speck0413/specter-proptroller/enclosure/docs/lid-hinges-latches.png

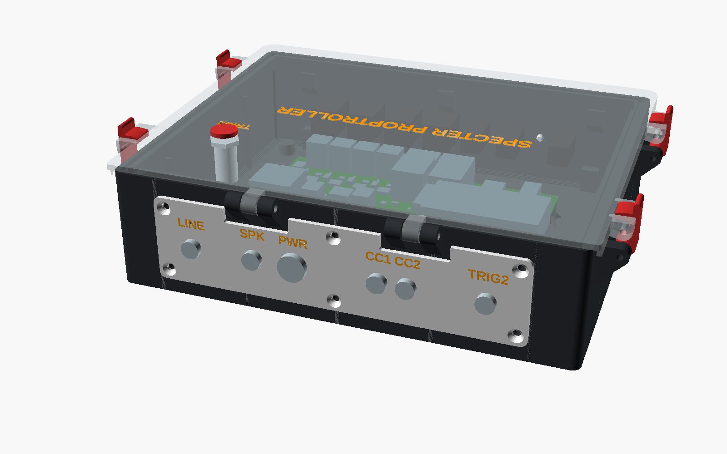
enclosure/docs/lid-hinges-latches.png
