speck0413/specter-proptroller/enclosure/docs/tub-underside.png

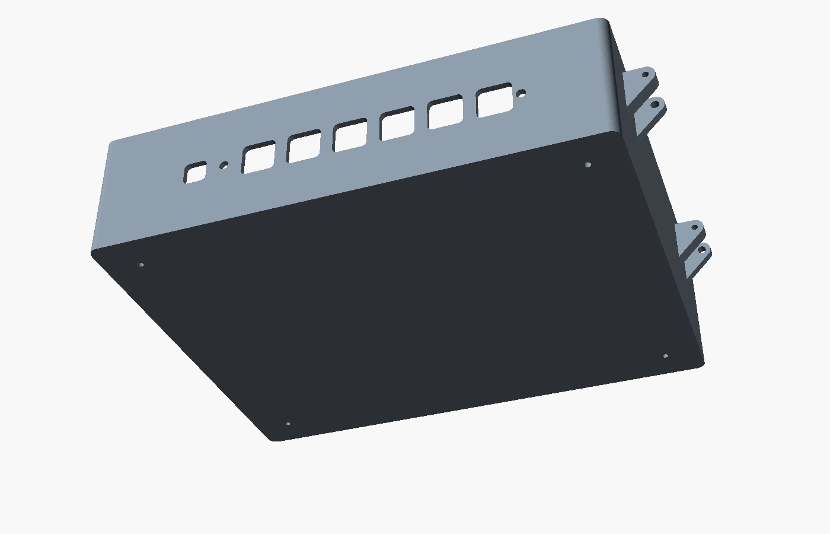
enclosure/docs/tub-underside.png
