speck0413/specter-proptroller/enclosure/docs/tub.png

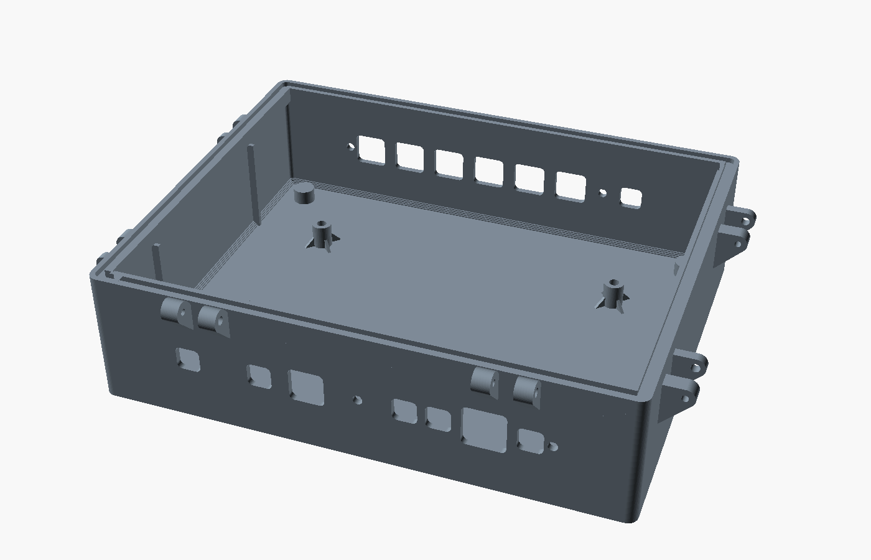
enclosure/docs/tub.png
