speck0413/specter-proptroller/hardware/fab/order/1-jlc-fits-everything/bom.csv

Comment | Designator | Footprint | LCSC Part #
DC-005-5A-2.0 24V | J_PWR | BarrelJack_Horizontal | C381116
100u/50V 50V Al-elec | C_BK1,C_BK2,C_DF | CP_Elec_8x10 | C970687
100n 50V X7R | C_BST,C_DFH,C_MCU,C_T1,C_T2 | C_0805_2012Metric | C49678
10u 16V X5R | C_LL,C_LR | C_0805_2012Metric | C1713
47p/50V 50V C0G | C_CF | C_0805_2012Metric | C14857
6.8n/50V 50V X7R | C_CP | C_0805_2012Metric | C1755
10u/50V 50V X5R | C_BI1,C_BI2 | C_1206_3216Metric | C13585
47u/10V 10V X5R | C_BO1,C_BO2 | C_1206_3216Metric | C96123
SMAJ24A | D_TVS | D_SMA | C19077541
SS56 60V | D_CT1,D_CT2,D_F1,D_F2,D_F3,D_F4 | D_SMA | C18199169
1N4148W | D_TC1,D_TC2 | D_SOD-123 | C81598
B5819W | D_C1,D_C2,D_DF,D_MCU | D_SOD-123 | C8598
PJ-320D | J_C1,J_C2,J_LO,J_T1,J_T2 | Jack_3.5mm_PJ320D_Horizontal | C431535
green | D_LO1,D_LO2,D_LO3,D_LO4,D_RL1,D_RL2 | LED_0805_2012Metric | C2297
220R@100M 3A | FB_BK,FB_DF | L_0805_2012Metric | C76818
10uH 8.8A | L_BK | L_Sunlord_MWSA1005S | C17700185
10k 1% | R_LO1,R_LO2,R_LO3,R_LO4 | R_0805_2012Metric | C17414
13k 1% | R_CP | R_0805_2012Metric | C17455
150k 1% | R_RT | R_0805_2012Metric | C17470
1k 1% | R_DFT,R_LL,R_LR,R_RB1,R_RB2,R_RL1,R_RL2,R_X1,R_X2,R_X3,R_X4,R_X5,R_X6,R_X7,R_X8,R_X9,R_X10,R_X11 | R_0805_2012Metric | C17513
220 1% | R_CA1,R_CA2,R_TR1,R_TR2 | R_0805_2012Metric | C17557
330 1% | R_PXS | R_0805_2012Metric | C17630
4.7k 1% | R_CP1,R_CP2,R_GD1,R_GD2,R_GD3,R_GD4,R_GS1,R_GS2,R_GS3,R_GS4,R_PD1,R_PD2,R_PD3,R_PD4,R_PXG,R_RP1,R_RP2,R_TS1,R_TS2,R_TU1,R_TU2 | R_0805_2012Metric | C17673
43k 1% | R_FB1 | R_0805_2012Metric | C17695
470 1% | R_PXU | R_0805_2012Metric | C17710
8.2k 1% | R_FB2 | R_0805_2012Metric | C17828
SRD-05VDC-SL-C | K1,K2 | Relay_SPDT_SANYOU_SRD_Series_Form_C | C35449
AO4485 | Q_O1,Q_O2,Q_O3,Q_O4 | SOIC-8_3.9x4.9mm_P1.27mm | C51499
LTV-217-B-G | U_C1,U_C2 | SOP-4_4.4x2.6mm_P1.27mm | C115450
2N7002 | Q_D1,Q_D2,Q_D3,Q_D4,Q_PX | SOT-23 | C8545
MMBT3904 | Q_R1,Q_R2 | SOT-23 | C20526
TS-1187A | SW_U1,SW_U2,SW_U3 | SW_Push_1P1T_XKB_TS-1187A | C318884
TPS54360BDDAR | U_BK | TI_SO-PowerPAD-8 | C524806
WJ500V-5.08-2P screw terminal | J_IN,J_O1,J_O2,J_O3,J_O4,J_SPK | TerminalBlock_5.08mm_1x02 | C8465
WJ500V-5.08-3P screw terminal | J_R1,J_R2,J_PX | TerminalBlock_5.08mm_1x03 | C72334
WJ500V-5.08-5P screw terminal | J_RAIL | TerminalBlock_5.08mm_1x05 | C42377750
2541FV-15P-B 1x15 female 8.5mm | J_DKN,J_DKS | PinSocket_1x15_P2.54mm_Vertical | C25503121
PM2.54-1X8PM-H85 1x8 female 8.5mm | J_DFA,J_DFB | PinSocket_1x08_P2.54mm_Vertical | C42431840
PZ254V-11-11P 1x11 male | J_XS,J_XV,J_XG | PinHeader_1x11_P2.54mm_Vertical | C2840011
2541FV-20P-B 1x20 female 8.5mm | J_PIN,J_PIS | PinSocket_1x20_P2.54mm_Vertical | C25503124
