speck0413/specter-proptroller/enclosure/params.scad

// generated by tools/print_params.py from design.toml and the board; edit design.toml, not this file

wall = 2.4;
floor_t = 2.0;
corner_r = 4.0;
row_v = 12.0;
standoff_h = 10.0;
inner_h = 51.0;
ribs = [-40.0, 40.0];
feet_in = 12.0;
feet_boss_d = 9.0;
feet_boss_h = 6.0;
feet_pilot = 2.5;
feet_depth = 7.0;
mount = "inset";
inset_d = 1.0;
inset_clr = 0.3;
inset_key = 6.0;
break_pitch = 20.0;
break_t = 0.8;
break_neck = 1.0;
plate_t = 3.0;
plate_r = 3.0;
plate_chamfer = 1.0;
pin_d = 3.3;
pin_l = 4.0;
pin_wall = 1.2;
ring_m = 1.0;
ring_edge = 3.5;
pg_w = 2.0;
pg_d = 1.0;
sg_w = 3.5;
sg_d = 1.6;
sg_m = 2.0;
sg_land = 3.6;
sg_edge = 1.75;
sg_round = 1.2;
screw_layout = "six";
screw_pitch = 36.0;
boss_w = 10.0;
boss_h = 8.5;
boss_len = 4.75;
j35_seat = 1.75;
label_h = 4.0;
label_base = 9.1;
label_gap = 1.0;
label_rows = 2;
inlay = 0.4;
gasket_clr = 0.1;
gasket_base = 0.4;
gasket_h = 2.8;
gasket_lip = 0.45;
gasket_tip = 0.85;
gasket_tip_lid = 1.2;
land_w = 7.0;
land_h = 6.0;
groove_w = 3.0;
groove_d = 2.0;
tongue_w = 1.6;
tongue_h = 0.7;
foam_t = 3.2;
seal_gap = 0.4;
lid_mount = "screws";
lid_screw_d = 4.5;
lid_screw_r = 3.75;
lid_screw_gap = 0.2;
lid_screw_pilot = 2.5;
lid_screw_depth = 6.0;
lid_ear_h = 6.0;
lid_screw_front = 14.0;
lid_screw_back = 4.5;
lid_t = 2.4;
lid_gap = 1.0;
skirt_t = 2.0;
drip = 4.0;
lid_rib_h = 5.0;
lid_rib_pitch = 40.0;
knuckle_d = 8.0;
knuckle_off = 1.25;
pin_span = 20.4;
knuckle_gap = 0.6;
latch_w = 10.0;
latch_drop = 12.0;
latch_bite = 0.4;
latch_in = 30.0;
latch_lead = 0.5;
latch_detent = 0.4;
latch_dip = 6.0;
latch_travel = 16.0;
latch_style = "cam";
dl_drop = 16.0;
dl_out = 9.5;
dl_r = 7.5;
dl_over = 15.0;
dl_squeeze = 0.5;
dl_reach = 2.6;
dl_tip_t = 2.8;
dl_pin = 4.0;
dl_lever_t = 8.0;
dl_ear_t = 4.0;
dl_plate_t = 3.5;
dl_gap = 0.4;
dl_ear_r = 4.0;
dl_boss_r = 4.2;
ear_t = 3.6;
title = "SPECTER PROPTROLLER";
ac = false;
ac_barrier_t = 2.0;
ac_bay_cap = 2.0;
ac_barrier_gap = 1.0;
ac_pocket_d = 34.0;
ac_pocket_m = 4.0;
ac_window_top = 2.0;
ac_sill_gap = 1.0;
ac_overlap = 3.0;
ac_rib_gap = 0.5;
ac_tie = [8.0, 8.0, 14.0, 5.0, 2.0];
ac_face_set = 0.25;
ac_earth_point = [4.0, 76.0];
ac_earth_hole = 3.2;
ac_earth_west = 17.5;
ac_earth_bend = 6.0;
ac_earth_niche = 6.0;
ac_earth2_point = [130.0, 4.0];
ac_earth2_back = 8.0;
win_m = 0.6;
pin_clr = 0.15;
hole_usb = 12.4;
hole_button = 10.4;
hole_j35p = 8.0;
hole_dcp = 12.0;
screw_head = 6.3;
screw_head_angle = 90.0;
screw_pan = false;
screw_d = 3.4;
insert_d = 4.0;
insert_depth = 6.5;
nut_af = 5.5;
nut_t = 2.4;
nut_clr = 0.2;
standoff_hole = 4.0;
standoff_depth = 7.0;
pin_pilot = 2.5;
plate_pilot = 2.5;
gasket_swing = 0.88;
gasket_lid_squeeze = 1.1;
gasket_lid_swing = 1.17;
knuckle_l = 6.4;
board_t = 1.6;
ix0 = -31.0;
ix1 = 164.0;
iyf = -118.0;
iyb = 38.0;
hinge_xs = [33.19, 99.81];
z_floor = 2.0;
z_board = 12.0;
z_row = 25.6;
z_top = 53.0;
latches = [["left", -88.0], ["left", 8.0], ["right", -88.0], ["right", 8.0]];
dl_p1 = [9.5, 37.0];
dl_p2 = [10.555, 29.575];
dl_k = [1.7, 55.3];
dl_lh = 27.207;
dl_snap = 0.186;
dl_open = 60;
button_xy = [129.0, 10.0];
lid_ears = [["left", -40.0], ["right", -40.0], ["front", -15.4], ["front", 148.4], ["back", -24.9], ["back", 157.9]];
ac_barrier = [];
ac_curtain = [];
ac_gland = [];
ac_earth = [];
ac_ties = [];
ac_cover = [];
ac_cover_bosses = [];
ac_chimney = [];
ac_seat = 0.0;
ac_seat_inset = 0.0;
ac_cover_z = 0.0;
ac_ribs = [];
ac_shelf = [];
ac_lip = [];
ac_stops = [];
ac_niche_out = [];
ac_earth2 = [];
feet_cap = 1.0;
board_w = 134; board_h = 80;
board_holes = [[4, -4], [130, -4], [4, -76], [130, -76]];
board_parts = [[57.5, -43.55, 1.6, 60.0, -40.55, 2.79], [115.85, -45.03, 1.6, 117.85, -43.78, 2.84], [109.82, -65.81, 1.6, 111.07, -63.81, 2.7], [60.73, -21.85, 1.6, 88.67, -19.31, 10.13], [18.05, -63.95, 1.6, 23.05, -61.25, 3.82], [88.75, -57.35, 1.6, 94.75, -52.44, 3.34], [101.75, -62.94, 1.6, 104.75, -60.44, 2.79], [15.97, -59.36, 1.6, 17.22, -57.36, 2.84], [26.1, -51.88, 1.6, 28.1, -50.62, 2.84], [25.0, -76.0, 1.6, 35.0, -64.5, 6.39], [28.5, -76.0, 1.6, 31.5, -64.5, 3.04], [49.4, -28.55, 1.6, 56.4, -25.95, 3.7], [27.45, -31.9, 1.6, 29.05, -28.1, 2.85], [40.4, -68.8, 1.6, 55.8, -49.2, 17.19], [102.95, -14.69, 1.6, 112.25, -0.49, 12.29], [74.25, -44.75, 1.6, 76.75, -41.75, 2.79], [96.5, -61.84, 1.6, 99.2, -56.84, 3.82], [37.8, -28.55, 1.6, 44.8, -25.95, 3.7], [34.2, -61.2, 1.6, 35.8, -58.0, 3.2], [20.7, -74.4, 1.6, 23.9, -72.8, 3.2], [77.05, -62.94, 1.6, 80.05, -60.44, 2.79], [11.45, -16.45, 1.6, 14.45, -13.95, 2.79], [85.13, -65.81, 1.6, 86.38, -63.81, 2.7], [30.75, -62.83, 1.6, 32.75, -61.58, 2.84], [61.72, -42.55, 1.6, 62.97, -40.55, 2.7], [122.18, -65.81, 1.6, 123.42, -63.81, 2.7], [89.4, -62.94, 1.6, 92.4, -60.44, 2.79], [68.4, -45.8, 1.6, 72.2, -44.2, 2.85], [113.45, -57.35, 1.6, 119.45, -52.44, 3.34], [84.15, -61.84, 1.6, 86.85, -56.84, 3.82], [86.95, -34.95, 1.6, 96.45, -26.65, 11.6], [87.55, -25.65, 1.6, 92.55, -22.95, 3.82], [121.2, -61.84, 1.6, 123.9, -56.84, 3.82], [60.73, -16.77, 1.6, 88.67, -14.23, 10.13], [76.4, -57.35, 1.6, 82.4, -52.44, 3.34], [111.95, -38.27, 1.6, 132.27, -35.73, 10.1], [108.43, -40.4, 1.6, 109.68, -38.4, 2.84], [60.73, -19.31, 1.6, 88.67, -16.77, 10.13], [102.2, -36.6, 1.6, 110.5, -27.1, 11.6], [79.1, -43.88, 1.6, 81.1, -42.62, 2.7], [26.8, -60.95, 1.6, 32.2, -56.05, 2.7], [20.7, -77.2, 1.6, 23.9, -75.6, 3.2], [108.85, -61.84, 1.6, 111.55, -56.84, 3.82], [24.83, -38.05, 1.6, 26.08, -36.05, 2.84], [27.65, -54.78, 1.6, 29.65, -53.53, 2.84], [111.95, -20.27, 1.6, 132.27, -17.73, 10.1], [12.7, -58.41, 1.6, 14.3, -54.61, 2.85], [112.78, -44.35, 1.6, 114.03, -42.35, 2.84], [101.1, -57.35, 1.6, 107.1, -52.44, 3.34], [58.5, -68.8, 1.6, 73.9, -49.2, 17.19], [114.1, -62.94, 1.6, 117.1, -60.44, 2.79], [55.55, -48.2, 1.6, 59.35, -46.6, 2.85], [90.65, -42.58, 1.6, 92.65, -41.33, 2.84], [24.53, -29.14, 1.6, 25.78, -27.14, 2.84], [97.48, -65.81, 1.6, 98.72, -63.81, 2.7], [77.85, -38.4, 1.6, 86.15, -28.9, 11.6], [103.25, -41.95, 1.6, 104.85, -38.15, 2.85], [36.55, -61.2, 1.6, 38.15, -58.0, 3.2], [106.0, -42.73, 1.6, 108.0, -41.47, 2.84], [20.1, -38.35, 1.6, 23.9, -36.75, 2.85], [19.5, -59.65, 1.6, 22.2, -54.65, 3.82], [2.23, -20.77, 1.6, 40.33, -18.23, 10.1], [2.23, -42.36, 1.6, 53.03, -39.82, 10.1], [2.23, -46.17, 1.6, 40.33, -43.63, 10.1], [2.23, -24.58, 1.6, 53.03, -22.04, 10.1], [89.28, -10.79, 1.6, 100.04, -0.54, 15.6], [77.36, -79.45, 1.6, 88.12, -69.2, 15.6], [89.71, -79.45, 1.6, 100.47, -69.2, 15.6], [102.06, -79.45, 1.6, 112.82, -69.2, 15.6], [114.41, -79.45, 1.6, 125.17, -69.2, 15.6], [40.48, -79.46, 1.6, 56.32, -69.21, 15.6], [58.58, -79.46, 1.6, 74.42, -69.21, 15.6], [8.55, -79.71, 1.6, 16.55, -65.6, 6.9], [27.0, -14.4, 1.6, 35.0, -0.29, 6.9], [38.6, -14.4, 1.6, 46.6, -0.29, 6.9], [50.2, -14.4, 1.6, 58.2, -0.29, 6.9], [125.9, -56.6, 1.6, 131.1, -50.1, 3.1], [125.9, -64.2, 1.6, 131.1, -57.7, 3.1], [125.9, -71.8, 1.6, 131.1, -65.3, 3.1], [7.97, -10.8, 1.6, 23.81, -0.54, 15.6], [113.08, -10.79, 1.6, 123.84, -0.54, 15.6], [119.6, -48.0, 1.6, 133.71, -40.0, 6.9], [71.4, -10.8, 1.6, 87.24, -0.54, 15.6], [61.24, -10.79, 1.6, 72.0, -0.54, 15.6], [-2.36, -46.3, 4.1, 50.09, -18.1, 17.15], [2.13, -42.7, 12.64, 54.48, -21.7, 16.29], [111.95, -38.16, 4.6, 132.27, -17.84, 16.35], [2.23, -24.58, 4.1, 53.03, -22.04, 15.64], [2.23, -42.36, 4.1, 53.03, -39.82, 15.64]];
// [id, label, face, X, kind]
conns = [["TRIG2", "TRIG2", "back", 3.86, "j35p"], ["CC2", "CC2", "back", 35.86, "j35p"], ["CC1", "CC1", "back", 47.86, "j35p"], ["PWR", "PWR", "back", 83.83, "dcp"], ["SPK", "SPK", "back", 101.6, "j35p"], ["LINE", "LINE", "back", 129.14, "j35p"], ["TRIG1", "TRIG1", "front", 5.29, "j35p"], ["RLY1", "RLY1", "front", 31.11, "j35p"], ["RLY2", "RLY2", "front", 49.11, "j35p"], ["OUT1", "OUT1", "front", 67.11, "dcp"], ["OUT2", "OUT2", "front", 87.31, "dcp"], ["OUT3", "OUT3", "front", 107.51, "dcp"], ["OUT4", "OUT4", "front", 127.71, "dcp"]];
j35p_hole_d = 8.0;
j35p_behind_d = 9.8;
j35p_rating_a = 0.3;
j35p_rating_v = 30.0;
dcp_hole_d = 12.0;
dcp_thread_l = 9.0;
dcp_behind_d = 12.0;
dcp_nut_c = 17.3;
usb_hole_d = 12.0;
usb_window = 16.0;
button_x = 129.0;
button_y = -10.0;
button_thread_d = 10.0;
button_head_d = 12.0;
button_body_d = 10.0;
button_depth = 20.0;
hinge_leaf_l = 25.4;
hinge_leaf_w = 12.7;
hinge_holes = [-7, 7];
hinge_hole_inset = 6.0;
hinge_pilot_d = 1.6;
outlet_face_w = 34.1;
outlet_face_h = 28.6;
outlet_face_pitch = 38.1;
outlet_open_m = 0.25;
outlet_screw_pitch = 83.3;
outlet_screw_d = 3.7;
outlet_screw_head = 7.0;
outlet_strap_l = 98.0;
outlet_strap_w = 24.0;
outlet_body_w = 36.0;
outlet_body_l = 66.0;
outlet_body_d = 31.0;
outlet_face_proud = 5.65;
gland_hole_d = 20.5;
gland_nut_d = 30.0;
gland_cap_d = 27.0;
gland_y = 102.0;
gland_z = 19.5;
front_opening = [[-0.21, 10.79, -5.5, 5.5], [10.79, 25.61, -5.5, 5.5], [25.61, 36.61, -5.5, 5.5], [36.61, 43.61, -5.5, 5.5], [43.61, 54.61, -5.5, 5.5], [54.61, 60.51, -5.5, 5.5], [60.51, 73.71, -6.6, 6.6], [73.71, 80.71, -6.6, 6.6], [80.71, 93.91, -6.6, 6.6], [93.91, 100.91, -6.6, 6.6], [100.91, 114.11, -6.6, 6.6], [114.11, 121.11, -6.6, 6.6], [121.11, 134.31, -6.6, 6.6]];
front_breaks = [14.97, 30.15, 45.33, 60.51, 78.96, 97.41, 115.86];
front_moved = [];
front_x0 = -10.71;
front_x1 = 143.71;
front_pf = [-13.8, 14.3];
front_pf_s = [-20.4, 20.7];
front_notches = [];
front_ring = [-3.21, 137.31, -10.3, 9.6];
front_pins = [[18.2, 0.0], [77.21, -5.5], [117.61, -5.5]];
front_screws = [[-6.06, -15.75], [66.5, -15.75], [139.06, -15.75], [-6.06, 16.05], [66.5, 16.05], [139.06, 16.05]];
front_boss_lens = [4.75, 4.75, 4.75, 4.75, 4.75, 4.75];
front_nuts = [1, 1, 1, 1, 1, 1];
front_seal = [[-6.06, 139.06, -15.75, 16.05], [[-6.06, -15.75, 5.35], [66.5, -15.75, 5.35], [139.06, -15.75, 5.35], [-6.06, 16.05, 5.35], [66.5, 16.05, 5.35], [139.06, 16.05, 5.35]], []];
front_windows = [[-0.21, 10.79, -5.5, 5.5, 0], [25.61, 36.61, -5.5, 5.5, 0], [43.61, 54.61, -5.5, 5.5, 0], [60.51, 73.71, -6.6, 6.6, 0], [80.71, 93.91, -6.6, 6.6, 0], [100.91, 114.11, -6.6, 6.6, 0], [121.11, 134.31, -6.6, 6.6, 0]];
front_labels = [["TRIG1", 5.29, 1, 4.0, 9.1], ["RLY1", 31.11, 1, 4.0, 9.1], ["RLY2", 49.11, 1, 4.0, 9.1], ["OUT1", 67.11, 1, 4.0, 9.1], ["OUT2", 87.31, 1, 4.0, 9.1], ["OUT3", 107.51, 1, 4.0, 9.1], ["OUT4", 127.71, 1, 4.0, 9.1], ["T=NO R=NC S=COM", 40.11, 2, 3.0, -12.1]];
front_conns = [["TRIG1", "j35p", 5.29, 0.0], ["RLY1", "j35p", 31.11, 0.0], ["RLY2", "j35p", 49.11, 0.0], ["OUT1", "dcp", 67.11, 0.0], ["OUT2", "dcp", 87.31, 0.0], ["OUT3", "dcp", 107.51, 0.0], ["OUT4", "dcp", 127.71, 0.0]];
back_opening = [[-134.64, -123.64, -5.5, 5.5], [-123.64, -107.1, -5.5, 5.5], [-107.1, -96.1, -5.5, 5.5], [-96.1, -90.43, -5.5, 5.5], [-90.43, -77.23, -6.6, 6.6], [-77.23, -53.36, -4.5, 5.5], [-53.36, -30.36, -5.5, 5.5], [-30.36, -9.36, -5.5, 5.5], [-9.36, 1.64, -5.5, 5.5]];
back_breaks = [-119.9, -105.17, -90.43, -77.23, -65.3, -53.36, -35.03, -16.69];
back_moved = [];
back_x0 = -146.79;
back_x1 = 13.79;
back_pf = [-13.1, 14.3];
back_pf_s = [-17.45, 20.7];
back_notches = [];
back_ring = [-137.64, 9.44, -9.6, 9.6];
back_pins = [[-65.3, 0.0], [4.64, 0.0]];
back_screws = [[-142.14, -12.8], [-66.5, -12.8], [9.14, -12.8], [-142.14, 16.05], [-66.5, 16.05], [9.14, 16.05]];
back_boss_lens = [4.75, 4.75, 4.75, 4.75, 4.75, 4.75];
back_nuts = [1, 1, 1, 1, 1, 1];
back_seal = [[-142.14, 10.29, -12.8, 16.05], [[-142.14, -12.8, 5.35], [-66.5, -12.8, 5.35], [9.14, -12.8, 5.35], [-142.14, 16.05, 5.35], [-66.5, 16.05, 5.35], [9.14, 16.05, 5.35]], []];
back_windows = [[-134.64, -123.64, -5.5, 5.5, 0], [-107.1, -96.1, -5.5, 5.5, 0], [-90.43, -77.23, -6.6, 6.6, 0], [-53.36, -30.36, -5.5, 5.5, 0], [-9.36, 1.64, -5.5, 5.5, 0]];
back_labels = [["LINE", -129.14, 1, 4.0, 9.1], ["SPK", -101.6, 1, 4.0, 9.1], ["PWR", -83.83, 1, 4.0, 9.1], ["CC1", -47.86, 1, 3.89, 9.1], ["CC2", -35.86, 1, 3.89, 9.1], ["TRIG2", -3.86, 1, 4.0, 9.1]];
back_conns = [["LINE", "j35p", -129.14, 0.0], ["SPK", "j35p", -101.6, 0.0], ["PWR", "dcp", -83.83, 0.0], ["CC1", "j35p", -47.86, 0.0], ["CC2", "j35p", -35.86, 0.0], ["TRIG2", "j35p", -3.86, 0.0]];
