speck0413/specter-proptroller/docs/wiring-guides/video/assets/board-top.webp

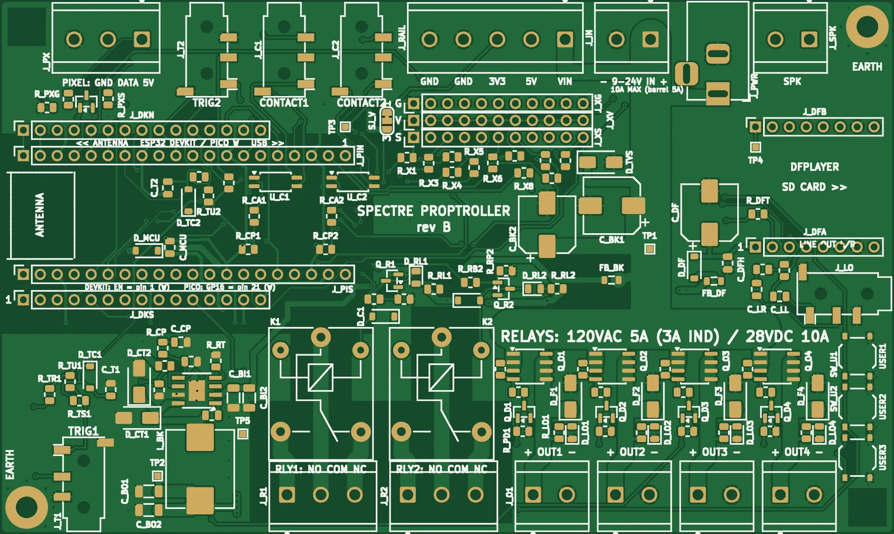
docs/wiring-guides/video/assets/board-top.webp
