speck0413/specter-proptroller/hardware/kicad/proptroller.kicad_pcb

## KiCad design hardware/kicad/proptroller.kicad_pcb (2026-10-23)

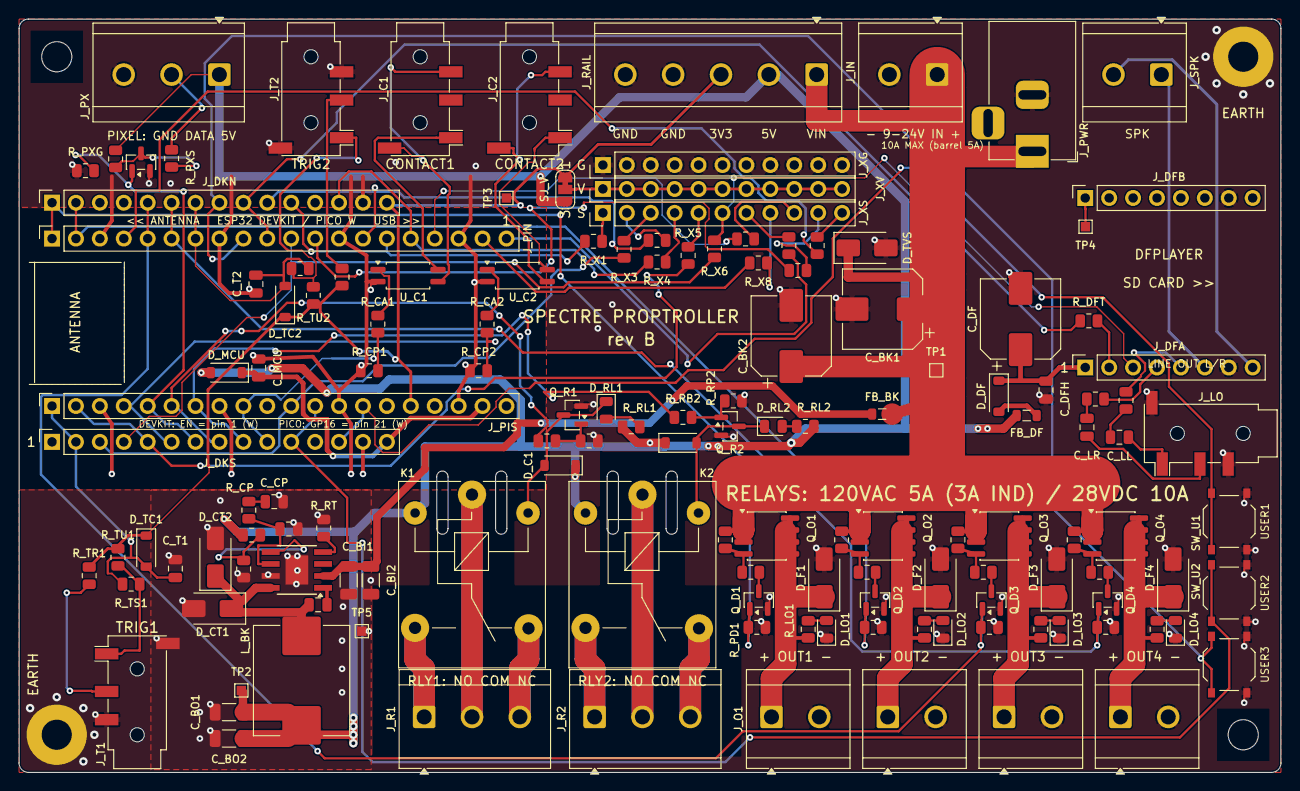
[picture p31: board proptroller.kicad_pcb from above]

Board: 2 copper layers, 134.0 x 80.0 mm, 145 parts (0 on the bottom side), 102 nets.

Parts:
C_BI1, C_BI2: 10u/50V; C_1206_3216Metric
C_BK1, C_BK2: 100u/50V; CP_Elec_8x10
C_BO1, C_BO2: 47u/10V; C_1206_3216Metric
C_BST: 100n; C_0805_2012Metric
C_CF: 47p/50V; C_0805_2012Metric
C_CP: 6.8n/50V; C_0805_2012Metric
C_DF: 100u/50V; CP_Elec_8x10
C_DFH: 100n; C_0805_2012Metric
C_LL: 10u; C_0805_2012Metric
C_LR: 10u; C_0805_2012Metric
C_MCU: 100n; C_0805_2012Metric
C_T1, C_T2: 100n; C_0805_2012Metric
D_C1, D_C2: B5819W; D_SOD-123
D_CT1, D_CT2: SS56; D_SMA
D_DF: B5819W; D_SOD-123
D_F1, D_F2, D_F3, D_F4: SS56; D_SMA
D_LO1, D_LO2, D_LO3, D_LO4: green; LED_0805_2012Metric
D_MCU: B5819W; D_SOD-123
D_RL1, D_RL2: green; LED_0805_2012Metric
D_TC1, D_TC2: 1N4148W; D_SOD-123
D_TVS: SMAJ24A; D_SMA
FB_BK: 220R@100M 3A; L_0805_2012Metric
FB_DF: 220R@100M 3A; L_0805_2012Metric
H1, H4: M3; MountingHole_3.2mm_M3
H2, H3: M3; MountingHole_3.2mm_M3_Pad
J_C1, J_C2: PJ-320D; Jack_3.5mm_PJ320D_Horizontal
J_DFA: 1x8 socket (DNP); PinSocket_1x08_P2.54mm_Vertical
J_DFB: 1x8 socket (DNP); PinSocket_1x08_P2.54mm_Vertical
J_DKN: 1x15 socket (DNP); PinSocket_1x15_P2.54mm_Vertical
J_DKS: 1x15 socket (DNP); PinSocket_1x15_P2.54mm_Vertical
J_IN: 5.08-2P (DNP); TerminalBlock_CUI_TB007-508-02_1x02_P5.08mm_Horizontal
J_LO: PJ-320D; Jack_3.5mm_PJ320D_Horizontal
J_O1, J_O2, J_O3, J_O4: 5.08-2P (DNP); TerminalBlock_CUI_TB007-508-02_1x02_P5.08mm_Horizontal
J_PIN: 1x20 socket (DNP); PinSocket_1x20_P2.54mm_Vertical
J_PIS: 1x20 socket (DNP); PinSocket_1x20_P2.54mm_Vertical
J_PWR: DC-005-5A-2.0; BarrelJack_Horizontal
J_PX: 5.08-3P (DNP); TerminalBlock_CUI_TB007-508-03_1x03_P5.08mm_Horizontal
J_R1, J_R2: 5.08-3P (DNP); TerminalBlock_CUI_TB007-508-03_1x03_P5.08mm_Horizontal
J_RAIL: 5.08-5P (DNP); TerminalBlock_CUI_TB007-508-05_1x05_P5.08mm_Horizontal
J_SPK: 5.08-2P (DNP); TerminalBlock_CUI_TB007-508-02_1x02_P5.08mm_Horizontal
J_T1, J_T2: PJ-320D; Jack_3.5mm_PJ320D_Horizontal
J_XG: 1x11 pin header (DNP); PinHeader_1x11_P2.54mm_Vertical
J_XS: 1x11 pin header (DNP); PinHeader_1x11_P2.54mm_Vertical
J_XV: 1x11 pin header (DNP); PinHeader_1x11_P2.54mm_Vertical
K1, K2: SRD-05VDC-SL-C; Relay_SPDT_SANYOU_SRD_Series_Form_C
L_BK: 10uH 8.8A; L_Sunlord_MWSA1005S
Q_D1, Q_D2, Q_D3, Q_D4: 2N7002; SOT-23
Q_O1, Q_O2, Q_O3, Q_O4: AO4485; SOIC-8_3.9x4.9mm_P1.27mm
Q_PX: 2N7002; SOT-23
Q_R1, Q_R2: MMBT3904; SOT-23
R_CA1, R_CA2: 220; R_0805_2012Metric
R_CP: 13k; R_0805_2012Metric
R_CP1, R_CP2: 4.7k; R_0805_2012Metric
R_DFT: 1k; R_0805_2012Metric
R_FB1: 43k; R_0805_2012Metric
R_FB2: 8.2k; R_0805_2012Metric
R_GD1, R_GD2, R_GD3, R_GD4: 4.7k; R_0805_2012Metric
R_GS1, R_GS2, R_GS3, R_GS4: 4.7k; R_0805_2012Metric
R_LL: 1k; R_0805_2012Metric
R_LO1, R_LO2, R_LO3, R_LO4: 10k; R_0805_2012Metric
R_LR: 1k; R_0805_2012Metric
R_PD1, R_PD2, R_PD3, R_PD4: 4.7k; R_0805_2012Metric
R_PXG: 4.7k; R_0805_2012Metric
R_PXS: 330; R_0805_2012Metric
R_PXU: 470; R_0805_2012Metric
R_RB1, R_RB2: 1k; R_0805_2012Metric
R_RL1, R_RL2: 1k; R_0805_2012Metric
R_RP1, R_RP2: 4.7k; R_0805_2012Metric
R_RT: 150k; R_0805_2012Metric
R_TR1, R_TR2: 220; R_0805_2012Metric
R_TS1, R_TS2: 4.7k; R_0805_2012Metric
R_TU1, R_TU2: 4.7k; R_0805_2012Metric
R_X1, R_X2, R_X3, R_X4, R_X5, R_X6, R_X7, R_X8, R_X9, R_X10, R_X11: 1k; R_0805_2012Metric
SJ_V: SJ3 1-2; SolderJumper-3_P1.3mm_Bridged12_RoundedPad1.0x1.5mm_NumberL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
SW_U1, SW_U2, SW_U3: TS-1187A; SW_Push_1P1T_XKB_TS-1187A
TP1: +VIN; TestPoint_Pad_1.0x1.0mm
TP2: +5V; TestPoint_Pad_1.0x1.0mm
TP3: +3V3; TestPoint_Pad_1.0x1.0mm
TP4: DF_BUSY; TestPoint_Pad_1.0x1.0mm
TP5: GND; TestPoint_Pad_1.0x1.0mm
U_BK: TPS54360BDDAR; TI_SO-PowerPAD-8
U_C1, U_C2: LTV-217-B-G; SOP-4_4.4x2.6mm_P1.27mm

Connections:
+3V3: D_TC1.1, D_TC2.1, J_DKN.15, J_PIS.16, J_RAIL.3, R_TR1.1, R_TR2.1, R_TU1.1, R_TU2.1, SJ_V.1, TP3.1
+5V: C_BO1.1, C_BO2.1, D_C1.1, D_C2.1, D_MCU.2, FB_DF.1, J_PX.1, J_RAIL.2, K1.2, K2.2, L_BK.2, R_FB1.1, R_PXU.1, R_RL1.1, R_RL2.1, SJ_V.3, TP2.1
+5V_DF: C_DF.1, C_DFH.1, D_DF.1, J_DFA.1
+5V_DFF: D_DF.2, FB_DF.2
+5V_MCU: C_MCU.1, D_MCU.1, J_DKS.15, J_PIS.19
+VIN: C_BK1.1, C_BK2.1, D_TVS.1, FB_BK.1, J_IN.1, J_PWR.1, J_RAIL.1, Q_O1.1, Q_O1.2, Q_O1.3, Q_O2.1, Q_O2.2, Q_O2.3, Q_O3.1, Q_O3.2, Q_O3.3, Q_O4.1, Q_O4.2, Q_O4.3, R_GS1.1, R_GS2.1, R_GS3.1, R_GS4.1, TP1.1
+VIN_BK: C_BI1.1, C_BI2.1, FB_BK.2, U_BK.2
AN_IN: J_DKS.3, J_PIS.11, R_X3.1
BK_BOOT: C_BST.1, U_BK.1
BK_COMP: C_CF.1, R_CP.1, U_BK.6
BK_CZ: C_CP.1, R_CP.2
BK_FB: R_FB1.2, R_FB2.1, U_BK.5
BK_RT: R_RT.1, U_BK.4
BK_SW: C_BST.2, D_CT1.1, D_CT2.1, L_BK.1, U_BK.8
CA1: R_CA1.2, U_C1.1
CA2: R_CA2.2, U_C2.1
COIL1: D_C1.2, D_RL1.1, K1.5, Q_R1.3
COIL2: D_C2.2, D_RL2.1, K2.5, Q_R2.3
CON1: J_DKS.10, J_PIS.9, R_CA1.1, R_CP1.1
CON2: J_DKS.6, J_PIS.4, R_CA2.1, R_CP2.1
CT1_A: J_C1.T, U_C1.4
CT1_B: J_C1.R2, J_C1.S, U_C1.3
CT2_A: J_C2.T, U_C2.4
CT2_B: J_C2.R2, J_C2.S, U_C2.3
DAC_L: J_DFA.5, R_LL.1
DAC_R: J_DFA.4, R_LR.1
DF_BUSY: J_DFB.1, TP4.1
DF_RX: J_DFA.2, R_DFT.2
DF_TX: J_DKN.9, J_PIN.10, R_DFT.1
EXP15: J_DKN.13, J_PIN.16, R_X4.1
EXP34: J_DKS.4, J_PIN.11, R_X6.1
EXP35: J_DKS.5, J_PIS.2, R_X5.1
EXP_GP0: J_PIN.20, R_X7.1
EXP_GP1: J_PIN.19, R_X8.1
EXP_GP2: J_PIN.17, R_X9.1
EXP_GP6: J_PIN.12, R_X10.1
EXP_GP13: J_PIN.4, R_X11.1
G1: Q_O1.4, R_GD1.1, R_GS1.2
G2: Q_O2.4, R_GD2.1, R_GS2.2
G3: Q_O3.4, R_GD3.1, R_GS3.2
G4: Q_O4.4, R_GD4.1, R_GS4.2
GD1: Q_D1.3, R_GD1.2
GD2: Q_D2.3, R_GD2.2
GD3: Q_D3.3, R_GD3.2
GD4: Q_D4.3, R_GD4.2
GND: C_BI1.2, C_BI2.2, C_BK1.2, C_BK2.2, C_BO1.2, C_BO2.2, C_CF.2, C_CP.2, C_DF.2, C_DFH.2, C_MCU.2, C_T1.2, C_T2.2, D_CT1.2, D_CT2.2, D_F1.2, D_F2.2, D_F3.2, D_F4.2, D_LO1.1, D_LO2.1, D_LO3.1, D_LO4.1, D_TVS.2, H2.1, H3.1, J_DFA.7, J_DFB.7, J_DKN.14, J_DKS.14, J_IN.2, J_LO.R2, J_LO.S, J_O1.2, J_O2.2, J_O3.2, J_O4.2, J_PIN.3, J_PIN.8, J_PIN.13, J_PIN.18, J_PIS.3, J_PIS.8, J_PIS.13, J_PIS.18, J_PWR.2, J_PX.3, J_RAIL.4, J_RAIL.5, J_T1.R2, J_T1.S, J_T2.R2, J_T2.S, J_XG.1, J_XG.2, J_XG.3, J_XG.4, J_XG.5, J_XG.6, J_XG.7, J_XG.8, J_XG.9, J_XG.10, J_XG.11, Q_D1.2, Q_D2.2, Q_D3.2, Q_D4.2, Q_PX.2, Q_R1.2, Q_R2.2, R_CP1.2, R_CP2.2, R_FB2.2, R_PD1.2, R_PD2.2, R_PD3.2, R_PD4.2, R_PXG.2, R_RP1.2, R_RP2.2, R_RT.2, SW_U1.2, SW_U2.2, SW_U3.2, TP5.1, U_BK.7, U_BK.9, U_C1.2, U_C2.2
LINE_L: C_LL.2, J_LO.T
LINE_R: C_LR.2, J_LO.R1
LL1: C_LL.1, R_LL.2
LO1: D_LO1.2, R_LO1.2
LO2: D_LO2.2, R_LO2.2
LO3: D_LO3.2, R_LO3.2
LO4: D_LO4.2, R_LO4.2
LR1: C_LR.1, R_LR.2
OUT1: D_F1.1, J_O1.1, Q_O1.5, Q_O1.6, Q_O1.7, Q_O1.8, R_LO1.1
OUT2: D_F2.1, J_O2.1, Q_O2.5, Q_O2.6, Q_O2.7, Q_O2.8, R_LO2.1
OUT3: D_F3.1, J_O3.1, Q_O3.5, Q_O3.6, Q_O3.7, Q_O3.8, R_LO3.1
OUT4: D_F4.1, J_O4.1, Q_O4.5, Q_O4.6, Q_O4.7, Q_O4.8, R_LO4.1
PIXEL: J_DKS.7, J_PIS.5, Q_PX.1, R_PXG.1
PIX_D5: Q_PX.3, R_PXS.1, R_PXU.2
PIX_DATA: J_PX.2, R_PXS.2
PWM1: J_DKN.1, J_PIN.1, Q_D1.1, R_PD1.1
PWM2: J_DKN.2, J_PIN.2, Q_D2.1, R_PD2.1
PWM3: J_DKN.5, J_PIN.5, Q_D3.1, R_PD3.1
PWM4: J_DKN.6, J_PIN.6, Q_D4.1, R_PD4.1
R1_COM: J_R1.2, K1.1
R1_NC: J_R1.3, K1.4
R1_NO: J_R1.1, K1.3
R2_COM: J_R2.2, K2.1
R2_NC: J_R2.3, K2.4
R2_NO: J_R2.1, K2.3
RB1: Q_R1.1, R_RB1.2, R_RP1.1
RB2: Q_R2.1, R_RB2.2, R_RP2.1
RLED1: D_RL1.2, R_RL1.2
RLED2: D_RL2.2, R_RL2.2
RLY1: J_DKS.8, J_PIS.6, R_RB1.1
RLY2: J_DKS.9, J_PIS.7, R_RB2.1
SCL: J_DKN.10, J_PIN.14, R_X2.1
SDA: J_DKN.11, J_PIN.15, R_X1.1
SPK1: J_DFA.8, J_SPK.2
SPK2: J_DFA.6, J_SPK.1
T1_RING: J_T1.R1, R_TR1.2
T1_TIP: J_T1.T, R_TS1.1, R_TU1.2
T2_RING: J_T2.R1, R_TR2.2
T2_TIP: J_T2.T, R_TS2.1, R_TU2.2
TRIG1: C_T1.1, D_TC1.2, J_DKS.2, J_PIS.1, R_TS1.2
TRIG2: C_T2.1, D_TC2.2, J_DKN.7, J_PIN.7, R_TS2.2
USER1: J_DKS.13, J_PIS.14, SW_U1.1
USER2: J_DKS.11, J_PIS.12, SW_U2.1
USER3: J_DKN.8, J_PIN.9, SW_U3.1
V_EXP: J_XV.1, J_XV.2, J_XV.3, J_XV.4, J_XV.5, J_XV.6, J_XV.7, J_XV.8, J_XV.9, J_XV.10, J_XV.11, SJ_V.2
XS1: J_XS.1, R_X1.2
XS2: J_XS.2, R_X2.2
XS3: J_XS.3, R_X3.2
XS4: J_XS.4, R_X4.2
XS5: J_XS.5, R_X5.2
XS6: J_DFA.3, J_XS.6, R_X6.2
XS7: J_XS.7, R_X7.2
XS8: J_XS.8, R_X8.2
XS9: J_XS.9, R_X9.2
XS10: J_XS.10, R_X10.2
XS11: J_XS.11, R_X11.2
