speck0413/specter-proptroller/firmware/arduino/test/golden-console/59-mqtt-fx-config_get_valve_time.txt

proptroller/front-door/config/valve_time [r] 750
