speck0413/specter-proptroller/(commit log)

2026-10-24 Specter Proptroller 0.1.0-rc.2
    Board packages as data on one generic image per chip; the show script says wait, plays numbered sounds from the card's mp3 folder and sets audio_volume; automatic turn-taking and remote starts by effect name; test presses for inputs; factory reset that keeps Wi-Fi; Cancel in the recorder; the board id in info; CI on every push; setup guides and the SD card guide.
    Claude-Session: https://claude.ai/code/session_01SYALcqJFLkQGcff1zuTtXq
2026-10-25 Sound: one sound per folder (sound N = the one file in folder NN) is the default
    sound.h: SoundMode::Folder is the default SOUND_MODE: play sound N with 0x0F (folder N, track 1), loop it with
    0x17 (the player loops the folder by itself, no "finished" needed). The mp3-folder and root modes stay behind
    the constant. SOUND_MAX_TRACK is SOUND_MAX_FOLDER (99) in Folder mode: the checker's range, the ambient and
    trigger settings and playSound(N) follow; messages say "sounds are numbered 1 to 99 ... (sound 5 is
    05/001-<name>.mp3)". Datasheet (FN-M16P 1.4): folders 01-99, files 001-255, text may follow the digits.
    Golden: traces read play 0x0F (N << 8) | 1 and loop 0x17 N through the mode; e21 is b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
2026-10-25 Step timing in mem: the longest 10 ms step and how many held up the 1 ms sampling or a whole tick
    Every board build reports, after the memory figures, 'step max N us, K of M steps over 1 ms, J over
    10 ms' since the last report (cleared on read), so the step's time can be measured on the bench
    without a scope.
    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
2026-10-25 Pixels: the strip's frame goes out in the background, the step never waits for the wire
    The WS2812 write blocked inside the 10 ms step (about 9 ms at 300 LEDs, 18 ms at 600: longer than a tick,
    every 20 ms), against the rule that the 1 ms sampling and the 10 ms tick never stall.
    - ESP32: rmt_write_sample without waiting, from a buffer the driver keeps (the RMT interrupt translates it
    while it sends); rmt_wait_tx_done with no wait first, because the legacy driver takes its transmit
    semaphore with no time limit.
    - RP2040: the frame goes from a buffer into the PIO FIFO by DMA (a channel claimed at begin) instead of
    pio_sm_put_blocking per pixel. PIXEL stays inverted on both (RMT idle hig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
2026-10-25 Show script: pixels = <effect> <colour> drives the pixel strip
    The smallest grammar that reads like the rest of the language: `pixels = chase red`, `pixels = rainbow`,
    `pixels = warm white` (a colour alone fills the strip), `pixels = comet 0x40ff80`, `pixels = off`.
    - Effects: off, fill, chase, rainbow, flash, fade, flicker, and new comet, sparkle, breathe, fire
    (Effect::Kind appended; shows' actions are unchanged). rainbow and fire have their own colours, the
    others are white without one.
    - Colours: red, orange, yellow, green, cyan, blue, purple, pink, white, warm white, or 0xRRGGBB (`#`
    starts a comment: a #rrggbb cut off that way gets its own message).
    - Speed is the new setting pix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
2026-10-25 Phone page: syntax colours in the script box, the language's words in one shared words.js
    - A highlight layer (<pre aria-hidden>) behind the script textarea, whose own text is transparent: the
    textarea stays the control, so typing, selection, Tab / Esc, its label and hint, the screen-reader
    behaviour and go-to-line are unchanged. The layer copies the box's font, padding and border, scrolls
    with it (scroll bars added as padding) and repaints at once on input and on every value set from code
    (an instance value setter: the stored script, a block edit, Revert; Tab now sends an input event, so the
    blocks follow it too). Keywords, outputs (and dmxN), inputs, on/off, numbers / units / tim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
2026-10-25 Step timing: the average step in mem too; a script's animation goes out at 50 frames a second
    `mem` now says "step max N us (average M)": on the bench the over-1-ms count alone could not tell a
    uniform overhead from the render ticks. test_script_board checks that a script's rainbow sends 50 frames
    a second (every 20 ms), not one a tick.
    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
2026-10-25 Step budget: the 1 ms sampling never stalls and the step stays under 1 ms with a script animating the strip
    Measured on the ESP32 DevKit (DIO 40 MHz flash, Wi-Fi on), a script animating 600 LEDs, 10 s windows: before,
    step average 1220 us, longest 2305 us, 966 of 1163 steps over 1 ms, and the step task often woke 1.2-1.7 ms
    late; now average 160-180 us, longest 337-594 us (600 and 16 LEDs, rainbow, comet, sparkle, fire), 0 over 1 ms,
    no sample lost.
    - Pixels: the step only hands over what the strip should show (Controller::publishPixels, a sequence lock,
    only when it changed); Controller::pixelService renders and sends outside the step and without the lock:
    a task on core 0 every 2 ms (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
2026-10-25 Web assets: the board serves its scripts and style sheet without comments (12.8 KB less flash)
    tools/web_assets.py drops whole-line // comments, indentation and blank lines from the scripts, and comments
    from the style sheet, before gzip. Only whole lines change, and a script with a multi-line template literal is
    left as it is. Gzipped web assets 73.0 to 60.2 KB; the Pico W image 769,852 to 757,188 B (82.4 to 81.1 % of its
    slot: still over the 80 % target). check-host's browser tests run against the slimmed files (470 ok).
    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
2026-10-25 ESP32 flash at QIO 80 MHz (owner 2026-10-25)
    - The esp32dev env: board_build.flash_mode = qio, f_flash = 80000000L (the Arduino IDE's "ESP32 Dev Module"
    default); the QEMU env stays DIO 40 MHz.
    - release.py merges the first-flash image with --flash_mode keep --flash_freq keep: the QIO bootloader's header
    says DIO 80 MHz, the mode the ROM reads it in, and the bootloader turns quad mode on. Merged with
    --flash_mode qio (tried on the bench) the ROM reads the bootloader in quad mode first and the board restarts
    over and over. test_release.py's fake esptool knows the new arguments.
    - Bench (ESP32 DevKit, the merged image written at 0x0 over USB): boots, the step averages 80-110 us, longes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
2026-10-25 The step never waits long for the lock: it copies the state, requests answer in windows
    The step waited up to 8 ms for the controller lock about 4 times a second while loop() built the state for the
    serial client or a page, and up to 5 ms for some requests. Now, on the ESP32 at QIO 80 MHz, 55-60 us with the
    serial state stream running and about 200-280 us while requests keep coming in (flash writes aside: a settings
    or script save stalls both cores whatever the lock does).
    - The state in two halves: captureState copies what the step changes into a StateSnap; renderState writes the
    JSON from it and from what only requests change (names, aliases, settings, the shows). The status values are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
2026-10-25 Sounds one per folder: the sound tile, blocks, typeahead and help use folder N (1-99); firmware at sound-folders
    Sound N is the one file in the card's folder NN (01/001-ambient.mp3). The Sound tile plays it with play_folder
    (folder N, track 1) and loops it with loop_folder; what plays now reads "/03/001" as "sound 3 · description"
    and "/03/ (loop)" as "on repeat". Sounds are 1 to 99 in the tile, the blocks' number editor, the card list and
    the typeahead; the hover help, block tooltip, new-effect note and C++ export note name the folder layout.
    Record plays folder N. Firmware submodule at sound-folders (91f77d9).
    Claude-Session: https: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
2026-10-25 SD card: one sound per folder (01/001-rain.mp3) instead of the mp3 folder
    Sound N is the single file in folder NN (01 to 99), starting with 001; the
    player plays folder N, track 1, so the copy order no longer matters.
    - Copy makes each folder fresh and writes 001-<description>.<ext> (byte copy,
    fsync of file and folder); more than 99 sounds is refused; a failure midway
    removes the half-written file and its folder and says how far it got.
    - Mac junk cleaned in the root and every sound folder; copy without formatting
    lists the root and each sound folder.
    - Check: not FAT, hidden files, other things in the root (the old mp3 folder
    named as the old layout), no sound folders, a folder wi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
2026-10-25 Sound tile e2e: no folder or track number field (the hint names folder 01)
    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
2026-10-25 mqtt test fleet_server_bridge_and_commands: polled deadlines instead of fixed sleeps and counted loops
    The run count was read once right after the state's Fleet event, but the board's three messages arrive one by one
    (failed about 1 run in 8 locally). Now: the run count, the far side's four topics, the bridge's connection and the
    allowed upstream request (asked again every half second until the reconnected bridge answers) are each waited for
    with a deadline; Fleet events are read until a 20 s deadline instead of 50/100 counted receives; the two broker
    ports are held at once so they are never the same port.
    Claude-Session: https://claud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
2026-10-25 USB flashing with PlatformIO installed by pip: esptool runs with that Python, a missing esptool is said in words
    esptool_command always used <pio home>/penv/bin/python, which only the official installer makes. With pio from
    pip (the CI runners, system packages) the spawn failed and Studio showed "No such file or directory (os error 2)"
    (e2e usb-package-switch failed on CI). The Python is now penv's, else the one beside the pio on PATH, else the one
    in pio's first line; no esptool yet says so ("flashing failed: PlatformIO has no esptool yet ..."), and a Python
    that cannot start is named. The Pico merge step uses the same Python.
    Claude-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
2026-10-25 e2e on CI: a plugin's first request refused without a dialog; every spec's page left running; beginner words
    The studio.spec plugin test failed on CI (and locally on 2 cores, 3 runs in 4) in three ways around the plugin's
    consent dialog. Traces showed the cause in Studio, not the test: Plugins.tsx's effect cleanup replaced the shared
    ask function with "no", and only a render put it back. React's development mode cleans up and runs effects again
    right after mounting, so until the plugin page next rendered a plugin's send_script was answered "the person said
    no" with no dialog (any effect re-run did the same in the desktop app). The effect now keeps its own `active`
    flag and the ask function n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
2026-10-25 Patterns: compiler (source to a portable numbers-only program) and a 16.16 interpreter with a per-frame step and time budget
    Written from the public description of the pattern language; no other implementation's code is used.
    Example patterns are our own (MIT). Unit tests for numbers, built-ins, controls, the runaway guard and .epe files.
    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
2026-10-25 LED patterns in Your library: editor with the pattern language's colours and help, live preview strip in a worker (60 fps, step and time guard, stalled-thread stop), controls as sliders and colour pi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
    Also a TODO in the effect language for the firmware's shared words.js (not on the firmware branch yet).
    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
2026-10-25 Sound tile: a repeat started here is stopped on leaving even before the board answered, and a late "not playing" does not forget it
    The repeat was only remembered once the board's answer came back, and any "not playing" state forgot it, including
    a late one from the sound before. On a slow run (sound-and-save e2e, locally and on CI) the repeat then kept
    playing after the board page closed. It is now remembered from the click, and forgotten only when the board stops
    playing after it started.
    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
2026-10-25 Activity bar tooltips let clicks through to the side bar under them (disableInteractive)
    The tooltip of the place just clicked opens to the right, over the side bar, and caught every click there until the
    pointer moved: on a slow CI run shell.spec's right-click on the Practice board 1 row waited behind the Boards
    tooltip until the test timed out (hotexit had the same with the Library tooltip). The tooltip is information only,
    so it no longer takes the pointer and closes when the pointer leaves the icon.
    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
2026-10-25 Pixels in effect scripts: firmware at dev rc2 f852f08; the show-script words come from firmware/web/words.js; a light-the-pixels block (effect and colour menus, exact colour picker writing 0xRRGGBB),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
2026-10-25 Pixels: e2e test for the block (effect menu, exact colour picker), typeahead, the help's link to LED patterns and the pattern page's note
    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
2026-10-25 e2e plugin test: each press in the plugin's frame is repeated until its result shows
    A click in the sandboxed plugin frame right after it appears can be lost (a trace: the button was there, the click
    landed on it, its handler never ran; Chrome routes input to the frame's own process only once it can). Each press
    in that test is now repeated until its result shows, only where pressing again changes nothing.
    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
2026-10-25 Firmware at af9ab35: 1 ms sampling never stalls with the strip animating, ESP32 at QIO 80
    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
2026-10-25 Show script: the tell line (checker, step table, runner)
    `tell <board> <effect>` and `tell <board> <setting> = <value>` name another board by its network name (or
    `all`) and one of its effects or settings. The checker reads the form only (it cannot know the other board's
    effects): board names as network labels, effect names as a remote start takes them (spaces as _), setting
    names one word, settings a board never takes from another refused at once, values 1-64 characters with their
    case kept. The names and values live in a 512-byte pool of the table (table format 3, after the steps; a
    format-2 table is checked again). The runner hands a tell line that ran to a ring of 8 for the network and g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
2026-10-25 Board link: tell lines reach other boards over MQTT or peer to peer
    The controller side and the peer-to-peer protocol, host-tested; the network loops follow.
    - Settings board_link (auto: MQTT when a broker is set, else Wi-Fi peer to peer; mqtt; wifi; off), link_group
    and link_key (set-only; sent empty from the console or set_params it is removed).
    - Out: the step hands the tell lines that ran over (a ring, link_work_); linkTake, in the network loop, logs each
    ("tell porch blackout: sent (Wi-Fi)"), keeps it for its answer (2 s, then "no answer from porch"; tell all
    counts the boards that answered), at most 20 a second. Over MQTT: <root>/<board>/control/<effect> and the new
    config/now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
2026-10-25 Board link in the simulator: UDP peer to peer, --link-peers, tools/link_check.py
    The simulator's network loop runs the peer-to-peer side (link.h) on its discovery socket: link frames are told
    apart from discovery by their magic, sent as a broadcast on the port, or to the addresses given with
    --link-peers (two simulators on one computer, each on its own discovery port). A session over MQTT subscribes
    again when the board link starts or stops going over MQTT.
    tools/link_check.py (run by check-host.sh) starts two simulators and mqtt_check.py's broker (the boards' logs
    are read from their MQTT events): a tell peer to peer over UDP on localhost starts the other board's effect and
    is answered; re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
2026-10-25 Board link on the boards: UDP on the discovery port, ESP-NOW on the ESP32
    The network loop (ESP32, Pico W, Pico 2 W) runs the peer-to-peer side (link.h) next to discovery: datagrams on
    the discovery port are told apart by their magic (up to 4 a pass); a frame goes out as a subnet broadcast on the
    Wi-Fi network and on the board's own hotspot (192.168.4.255), and on the ESP32 also as an ESP-NOW broadcast on
    the existing peer (the cues' one, same channel as the station and the hotspot). ESP-NOW frames are queued by the
    Wi-Fi task in a queue of their own (8 frames), so they are handled whether an MQTT session is up or not. Replies
    go back the way the request came (UDP to its address, or ESP-NOW)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
2026-10-25 Board link: the phone page's tell block, SHOW-SCRIPT.md §11, PROTOCOL.md "Board link"
    - web/blocks.js: a "tell a board" block (ps_tell: the board, then the effect or `setting = value`), read before
    the output line since a tell line may hold "=", written back as `tell <board> <what>`; blocks-test covers the
    round trip. `tell` is coloured as a keyword (words.js, earlier). The phone page shows the board link's log
    lines with the other events.
    - SHOW-SCRIPT.md §11 (SS-B1-B6): two boards' scripts, what a tell does on the other board (its gates, settings
    used and not saved), that it never waits, the logs, board_link, groups and the key (and that without a key anyone
    on the network can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
2026-10-25 Editor hover help is seen whole: popups placed against the window, not clipped by the editor's box
    Monaco drew its hover help and suggestion list inside the editor, whose box clips what spills out: the help for
    hsv in the pattern editor was cut off on the right, the help for pixels in the effect editor lost its first line
    at the top. Every Studio editor (CodeEditor and the compare view) now gets fixed overflow widgets, so Monaco keeps
    them inside the visible area. Tests: vitest for the shared options, e2e checks that each corner of the hsv and
    pixels help is drawn and inside the window.
    Claude-Session: https://claude.ai/code/session_01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
2026-10-25 Board link: no late tells after a broker outage; boards on another board's hotspot are not covered
    - Tells queued for MQTT carry when they were told: mqttPoll drops one older than the answer time (it was logged
    "no answer" already), the queue holds at most 16, and a new session starts with none, so a broker that comes
    back never starts effects late (test_link).
    - PROTOCOL.md and SHOW-SCRIPT.md: peer to peer is for boards on the same Wi-Fi network. Boards joined to another
    board's hotspot do not hear each other that way (every hotspot is 192.168.4.1/24, so such a board has two
    networks at 192.168.4.x); ESP32 boards still do by ESP-NOW.
    - test_script_record: the largest script's record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
2026-10-25 Firmware at 211a795: board link and the tell line
    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
2026-10-25 No colours offered after rainbow, fire or off: the block's colour menu follows the effect
    The text typeahead already offered no colours after `pixels = fire `, `rainbow ` and `off ` (checked by hand on
    every typing path; now pinned by vitest and an e2e guard). The block's colour menu did not: after fire, rainbow
    and off it still listed every colour and the exact colour picker, and picking one wrote `pixels = fire red`,
    which the board's checker rejects ("fire takes no colour"). The menu now holds only "its own colours" (rainbow,
    fire) or "no colour (dark)" (off); a colour already written after one is kept as written and marked
    "(fire takes no colour)"; the colour's words follow when the effe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
2026-10-25 Patterns: board-exact interpreter (integer maths, 16-bit random, board limits), program bytes for a board, golden vectors, clue puzzle example
    The preview now computes every built-in with integers only (fixed.ts), so the board's C++ interpreter can give
    the same lights bit for bit; results stay within 1e-4 of the exact values. The board's limits (BOARD_LIMITS:
    code, globals, functions, controls, stack, depth, locals, list values, steps a frame) are the preview's too;
    literal lists now count against the list values. encode.ts is the byte layout a board stores ("SPAT", format 1).
    golden/cases.ts holds the shared vectors' patterns; PATTERN_GOLDEN_OUT writes them into the firmware tree and
    patte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
2026-10-25 Typeahead and help for tell: the boards Studio knows by network name and all, then that board's effects; plain-words help (remote starts allowed, settings used but not saved)
    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
2026-10-25 LED patterns: the interpreter, bit for bit Studio's (integer maths, program check), with the shared golden vectors
    pattern_vm runs the program Specter Studio compiles (the board never compiles source): every step, jump, index
    and the stack height are checked once when the bytes are read, and every limit is fixed (PATTERN_MAX_*, the same
    numbers as Studio's BOARD_LIMITS). pattern_math.h is Studio's fixed.ts step for step. firmware/pattern-golden
    holds the vectors Studio's interpreter writes; test_pattern_vm checks every case byte for byte, its errors,
    damaged and cut programs (no read outside them under native_asan), and the clue puzzle solved out of order.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
2026-10-25 Patterns: a list takes one more value (where a board keeps its length), so both interpreters count the same
    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
2026-10-25 Practice boards can tell each other (sim_start link_peers: the simulator's --link-peers); e2e: one practice board's tell line starts an effect on another, link key set-only
    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
2026-10-25 Bare devkits: ESP32-S3 and ESP32-C3 chip support and three generic BSPs
    The firmware runs on a bare ESP32 30-pin DevKit, an ESP32-S3 DevKit and an ESP32-C3 SuperMini, each with a board
    support package in bsp/ (every pin choice and how to adapt it commented) and its own env (esp32dev_generic,
    esp32s3_generic, esp32c3_supermini, all in default_envs).
    - Mcu gains Esp32S3 and Esp32C3 ("esp32-s3", "esp32-c3" as info.mcu and a board package's mcu), with each chip's
    pin rules (flash / PSRAM, USB, UART0, strapping, ADC1-only analog) and its devkit as the built-in board.
    - The bare maps (pins.h, board-packages/*.json): outputs on plain GPIOs, inputs on the chip's pull-ups, PIXEL not
    inverted; th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
2026-10-25 Release files for the bare devkits: update and first-flash images, a bare-devkit flasher button
    release.py packages the three bare images beside the existing ones (names unchanged for those):
    generic-<board>-<v>.bin and first-flash-<board>-<v>.bin for esp32-devkit-bare, esp32-s3-devkit and
    esp32-c3-supermini, merged per chip (bootloader at 0x1000 on the ESP32, 0x0 on the S3 / C3, flash mode and speed
    kept from the bootloader, 4 MB). The manifest names each image's board (info.board), the Proptroller board's
    entries first for each mcu. The browser flasher keeps manifest.json (the Proptroller board's ESP32) and adds
    manifest-bare.json, one build per chip family (ESP32, ESP32-S3, ESP32-C3), beh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
2026-10-25 Bare-devkit boards: name the ESP32-S3 and ESP32-C3, test the update pick with the bare images
    The firmware's bare-devkit images (BARE-DEVKIT.md: esp32-devkit-bare, esp32-s3-devkit, esp32-c3-supermini) report
    info.mcu esp32-s3 / esp32-c3 for the new chips: boardKind names them. The release list now carries those images
    with their board; a test checks that image_for gives a bare ESP32 DevKit the bare image, a Proptroller board (or
    one from before the board field) the Proptroller one, and the S3 and C3 their own.
    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
2026-10-25 LED patterns on the board: stored by name, played on the pixel side, pixels = pattern and pixels press in show scripts
    - put_pattern / list_patterns / delete_pattern (the program's bytes as base64, the control values to start with):
    checked when received (every limit in plain words), at most 8 in one A/B record (/patterns-a.bin, packed,
    8 KB), written only when nothing runs (or a minute after the change), refused while the page lock is on
    without the password, while a new image waits for its self-check, and while a newer or unreadable record is
    kept; a factory reset clears them. Capability "patterns" (ESP32, Pico 2 W, the simulator).
    - The step never runs pattern code: it picks the s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
2026-10-25 Run it on a bare devkit: the guide, the S3 image in QEMU, docs
    - firmware/BARE-DEVKIT.md: the driver warning, wiring tables for the ESP32 30-pin DevKit, the ESP32-S3 DevKit and
    the ESP32-C3 SuperMini, flashing, the safe pins per chip, adapting with a board package or a BSP copy, timing
    (what is measured and what is not); linked from README and GETTING-STARTED.
    - tools/qemu/run-esp32.sh --s3: the bare S3 image without Wi-Fi (env esp32s3_qemu) on QEMU's esp32s3 machine, the
    serial smoke test (drive.py --machine / --mcu): 27 of 27 checks with a 60 s soak; step max 340-575 us, no sample
    lost. QEMU's S3 has no LEDC and no RMT (PROPTROLLER_QEMU_NO_LEDC, that env only). The smoke test's "th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
2026-10-25 Practice boards tell each other out of the box: each gets an id of its own and a UDP port in a link relay on this computer that repeats board link frames between running practice boards
    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
2026-10-25 Typeahead after "tell <board> ": after its effects, the settings that board takes from another (read from the board: no secrets, nothing that needs a restart, not the checker's refused list)
    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
2026-10-25 C3: a 4 KB USB-CDC send buffer instead of a zero timeout; sound port and DMX never share the C3's UART
    - A zero send timeout on the C3's USB-CDC cut every line longer than the core's 256 B buffer (state lines, a
    backup). Now the buffer is 4 KB (PT_USB_CDC_TX_BYTES) and the core's own 100 ms limit stays: a computer that is
    plugged in but not reading holds a write in loop() at most that long, never the step.
    - The C3 has one UART for the sound player and the DMX port on S4: a board package with both is refused in plain
    words, a BSP with both does not build (c3UartsOk), the C3 BSP says so.
    Claude-Session: https://claude.ai/code/sess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
2026-10-25 USB install of the bare ESP32-S3 and ESP32-C3 first-flash images
    release_plan takes the S3's and C3's merged first-flash images (bootloader at 0x0, the header's chip id checked)
    and esptool_command passes the plan's chip (esp32s3 / esp32c3) instead of always esp32. A board package in the same
    write (fsimage) is still ESP32 / Pico only.
    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
2026-10-25 LED patterns: depth 12 (the interpreter's native stack, checked by stack_check), no window reads of the step's picture, the pixel test follows a pattern sent again
    - PATTERN_MAX_DEPTH 12 (Studio's BOARD_LIMITS.depth too; vectors regenerated): an LED pattern's exec and built-in
    frames twelve deep plus the path to the pixel side take 4.6 KB of the Pico 2 W's core 0 (7 KB after lwIP's
    allowance) and 5.2 KB of the ESP32's 8 KB pixel task; stack_check.py now counts the recursion that many times.
    - list_patterns answers with the lock (it reads the step's picture); the loop records the pattern it handed over
    from before its window; put_pattern measures the record without copying the list.
    - T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
2026-10-25 Patterns: a board's call depth is 12 (its native stack), the golden cases follow
    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
2026-10-25 Firmware at 698fa9a: board-to-board tell, bare ESP32 / S3 / C3 devkits
    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
2026-10-25 LED patterns: the interpreter faster on the boards (O2, 32-bit divides where they fit, no per-pixel x unless render2D/3D), a 250 ms frame deadline, mem's frame average
    Measured in QEMU (esp32dev_qemu, icount shift 2, 600 lights): the heavy golden pattern takes 32.5 ms a frame on
    average (36.6 ms at most, 42,021 steps of the 98,304 budget) where it took 52 ms; the step stays at 40 us at most
    with 0 of 1,025 over 1 ms. A 25 ms or 50 ms deadline stopped it when a flash write stalled the core, so the
    deadline is now 250 ms as in Studio's preview: the step budget stops a loop that never ends (153 ms in QEMU),
    the deadline only what steps do not count. The results are bit for bit the same (golden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
2026-10-25 LED patterns: docs (SHOW-SCRIPT SS-X7/SS-X8, PROTOCOL "LED patterns", FLASH-MAP record and block budget, QEMU numbers), the clue puzzle example, the phone page's pixel test plays a stored pattern
    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
2026-10-25 Example scripts test: the boards' USER buttons are triggers, a press may press a pattern's button or run a pixels line; nine public examples
    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
2026-10-25 Simulator: op sim_pixels (the lights the strip shows), for end-to-end tests of LED patterns
    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
2026-10-25 ESP32 pixels: the RMT driver is installed on a task of its own, not on the 1 KB IPC stack
    - BoardPixels::begin ran rmtInstall through esp_ipc_call_blocking. The IPC task's stack is 1 KB
    (CONFIG_ESP_IPC_TASK_STACK_SIZE); a failed install logs (ESP_LOGE, a printf) and overflowed it into the
    heap. In QEMU, whose RMT makes rmt_translator_init fail, the ready line's heap walk
    (ESP.getMaxAllocHeap in memoryReport) then faulted with LoadStorePIFAddrError: the stage 2 smoke run has
    failed since 5d3c8c8 (found by bisect; not the QIO change). A failed install on a board does the same.
    - Now a short task pinned to core 0 (so the RMT interrupt stays off the step's core) with a 4 KB stack runs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
2026-10-25 QEMU stage 1: a DIO 40 MHz build of the esp32dev firmware (QEMU cannot run QIO)
    - Since the esp32dev env moved to QIO 80 MHz, stage 1 merged that image as DIO 40 MHz and the app's own
    flash init asserted (do_core_init startup.c:328). Merging with the header kept, as release.py does, fails
    the same way: QEMU's flash model cannot run a QIO app, so merge flags cannot fix it.
    - New env esp32dev_qemu_wifi: esp32dev (Wi-Fi included) at DIO 40 MHz, QEMU only, not a default env, no
    stack_post.py. esp32dev_qemu (stage 2) extends it with PROPTROLLER_NO_WIFI. The release image stays QIO
    80 MHz, merged with --flash_mode keep --flash_freq keep; it is checked on the bench, not in QEMU.
    - run-esp32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
2026-10-25 LED patterns to boards: "Send to a board…" (boards with the patterns capability; compiled, checked and tried at the board's light count first; the board's answer shown), pixels = pattern and pixels p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
    - SendPattern.tsx / send.ts: put_pattern with the program's bytes and the preview's control values (16.16),
    through the store's change() (the page password when the board is locked). Refused before sending, in plain
    words: a name a board does not keep, a pattern over the board's limits, or one that would stop on the board at
    its pixel_count. Boards without a player are named, not offered.
    - patterns/known.ts: the patterns of the board being checked with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
2026-10-25 LED patterns: QEMU numbers from the image as built (the pixel driver's install now fails cleanly there): heavy pattern 21 ms a frame on average, step max 109 us, 0 over 1 ms
    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
2026-10-25 LED patterns: list_patterns reads the controls kept with each pattern (no program decoded with the lock held); put_pattern checks the program's bytes with the lock given back
    Measured in QEMU with 8 patterns near the 24 KB limit and the heavy one playing: 20 list_patterns, lock wait max
    199 us, step max 40 us.
    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
2026-10-25 Firmware at d2ba517: the LED pattern player, pixels = pattern and pixels press
    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
2026-10-26 Show scripts: an effect may start with any line and have any number of wait for lines
    The lines above an effect's first "wait for" run at power-on, straight away, and again every time the effect
    comes back to its top (a background sound, a lamp that glows while the prop waits). An effect with no
    "wait for" goes round and round from power-on; the checker refuses one that takes no time (M-nopause replaces
    M-first: 'effect "x" never waits, so it would repeat without a pause. Add a "wait 5" or a "wait for trig1".').
    Runner: the first wait for is the top; a run goes from it through the last line and the lines above it. Lines
    above the first wait for and effects with no wait for hold their output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
2026-10-26 Effects that do not start with a wait for: firmware with free starts, help, blocks, C++ export, run length, tests
    The firmware submodule moves to the show-script change where an effect may start with any line: the lines
    above its first "wait for" run at power-on and after every run (a background sound), an effect may have
    several "wait for" lines or none, and one with none must take time (the board's new message: 'effect "x"
    never waits, so it would repeat without a pause. Add a "wait 5" or a "wait for trig1".'). The checker and
    the practice boards are that firmware's own, so Studio's checks and simulator follow it.
    - Hover help for wait and audio_loop, the effect and loop block tooltips: n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
2026-10-26 Show scripts: effects with no wait for that share an output take turns, a time round each
    When an effect's time round ends, the effects waiting to begin their first line (another effect with no wait
    for, the lines above a first wait for at power-on) go after the starts that waited and before it goes round
    again, so two effects with no wait for on one output alternate instead of one holding it for ever. SS-R9 says
    which power-on rules apply (the lines above a first wait for start straight away), PROTOCOL.md what
    state.script.effects[].running means now. Golden trace t40; a phone blocks test builds an effect with no wait
    for block.
    Claud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
2026-10-26 Firmware: effects with no wait for that share an output take turns
    Moves the firmware submodule to the show-script fix where two effects with no wait for on one output take turns,
    a time round each (golden trace t40).
    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
2026-10-26 Show scripts: a limit in an effect with no wait for is refused (M-limitnowait)
    A limit counts the runs that start at an effect's first wait for, so the checker refuses one in an effect with
    no wait for, on the limit line: 'a limit counts runs, and effect "candle" has no "wait for" to start one. Add a
    "wait for trig1", or remove the limit.' (owner). Golden README and case e53, SHOW-SCRIPT.md SS-R1 and SS-G3.
    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
2026-10-26 Firmware: a limit in an effect with no wait for is refused; the limit help and the ambient e2e say so
    Moves the firmware submodule to the checker that refuses a limit in an effect with no wait for (M-limitnowait,
    golden case e53). The limit hover says it belongs in an effect with a wait for; ambient.spec.ts checks the board's
    message.
    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
2026-10-26 Board link on hardware: PropApp forwards the link calls
    The boards' NetApp (PropApp in Proptroller.cpp) did not forward linkEpoch, linkWork, linkConfig, linkTake,
    linkIn and linkAnswer, so the network loop got NetApp's defaults: on an ESP32 a tell line was never sent
    (no "sent" log, nothing on UDP or MQTT) and no peer-to-peer tell was taken, while the host tests (which use
    the simulator's NetApp) all passed. Found on the bench ESP32 DevKit and in QEMU.
    test_link: the_board_forwards_every_netapp_call reads netapp.h and PropApp and fails for any NetApp call
    PropApp leaves out.
    Claude-Session: https://claude.ai/code/session_01SYALcqJFLkQ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
2026-10-26 A setting change no longer stalls the step: settings compared with the lock given back
    setParams decided whether to save by comparing the new and the stored settings, which writes both as JSON:
    9.2-9.3 ms on the bench ESP32 DevKit, under the controller lock. Every setting change (the console, a page,
    MQTT, another board's tell) held the step that long: wake gap 10.4-11.1 ms, samples handled up to 10 ms late
    (none lost). The comparison now runs in a window (the settings never change in one), and not at all for
    another board's change, which is never saved. On the bench: wake gap 1.0-1.2 ms after the fix.
    test_safety: a_setting_change_compares_without_the_lock (one window for a change here, no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
2026-10-26 Firmware ffb42f7: board-to-board tell works on real boards; a setting change no longer stalls the step
    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
2026-10-28 Studio builds against the repository's firmware/: no firmware submodule
    The simulator, the bundled firmware, the firmware library and template in the bundle, the wiring guides, the
    golden sets and the shared web modules (words.js, take.js) come from ../firmware and ../docs. The dev server may
    serve ../firmware/web. build-sim.sh and bundle-firmware.py put the regenerated web_assets.h back only when it and
    firmware/web had no changes before the build. setup.sh / setup.ps1 check for ../firmware instead of checking out
    a submodule; checker-parity.sh defaults to this repository's HEAD.
    Claude-Session: https://claude.ai/code/session_01SYALcq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
2026-10-28 CI: one set of workflows for the firmware and Studio, with path filters and studio-v tags
    firmware.yml (was ci.yml): the firmware jobs, on changes to firmware/. firmware-release.yml (was release.yml):
    unchanged, on v<firmware/VERSION> tags. studio.yml (was Studio's build.yml): tests and e2e on changes to studio/
    or firmware/; the installers only when studio/ changed, on a studio-v tag or by hand; the release on
    studio-v<version> tags, checked against package.json, tauri.conf.json and Cargo.toml.
    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
2026-10-28 Docs: one repository for the board, the firmware, the enclosure and Specter Studio
    README: Studio in studio/, Studio from source, the release tags; GETTING-STARTED, DEV-SETUP and FIRMWARE-BUILD
    clone this repository and cd studio; Studio's README, BUILDING and DESIGN use ../firmware and describe studio.yml
    and studio-v releases. The VS Code workspace opens studio/ as a folder.
    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
2026-10-29 Skills: the Rust firmware skill is gone (there is no Rust firmware); polled-deadline rule in the Arduino skill
    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
2026-10-29 Examples build again: the C3 UART check is a C++11 constexpr, outside the C++14-only block (board_package.cpp calls it at run time)
    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
2026-10-29 Enclosure in Fusion: a script that builds the standard case as a parametric design (user parameters from design.toml, dimensioned sketches, grouped timeline; tub, lid, both faceplates, four latches a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
    Claude-Session: https://claude.ai/code/session_01FQjRHntHiX55kUnuJmQwiX
2026-10-29 Enclosure: tools/fusion_check, the Fusion script built without Fusion (a SolidCraft-backed stand-in for the API it calls) and compared part by part with the OpenSCAD model; check.sh writes cad/specte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
2026-10-29 Enclosure in Fusion: the lid's knuckle web joined before the knuckle (it touches the lid, the knuckle alone doesn't), the timeline groups reset on each run; check.sh's offset sign fixed; README: the 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
2026-10-29 Enclosure in Fusion README: what a wall change leaves behind
    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
2026-10-29 Enclosure: the lid screwed on, inset faceplates over one opening, an inline try-out, TRIG2 in a rib cell, taller TPU gaskets (owner 2026-10-24)
    - Lid: lid_mount = "screws" (the default): six countersunk M3 x 12s through bosses on the lid's edge into ears on the tub's
    outside walls, outside the seal; two on each long wall near its ends (front and back offsets differ, so it fits one way
    round), one in the middle of each end wall (the AC front pair on the end walls); a skirt all round. lid_fea: lift 0.37-0.85
    mm (standard) against 0.64-1.18 with the latches and hinges; AC unchanged. The hinged lid stays in the model (lid_mount =
    "hinge"), not built.
    - Faceplates: mount = "inset" (the de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
2026-10-29 Enclosure README: a thin washer behind each DC nut on the inset tub (it sits over the 13.2 mm opening), the hinged lid smoke-tested, the Fusion check's configuration
    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
2026-10-29 Enclosure: regenerate the Fusion layout block (TRIG2 button), guard fusion_layout.py, tidy docs
    The Fusion script's BUTTON now follows TRIG2's rib cell. fusion_layout.py asserts the screws + hinge
    configuration it models. The Lid row of the Fusion volume table is marked not re-measured. Docs state
    current values only; check.sh uses $PY throughout.
2026-10-29 Studio: steady the USB reconnect test
    The fake board left after a fixed count of answers, so under load it could vanish
    as it sent its last answer; the session saw the port die before the answer and the
    test then waited for a port that was only supplied afterwards. The fake board now
    stays until told to go, skips blank lines, and the test polls a deadline.
2026-10-29 firmware: a script effect started remotely is an api run
    PROTOCOL.md says a run's source is `api` for the web page, MQTT, POST /rpc
    and the serial port. A show and the pulse-and-recover effect report it so,
    but a show-script effect started by name (action, MQTT control/<effect>,
    another board's tell) was counted as `input`. The script runner now counts
    the starts that took a queued remote start, and the run event says `api`
    for those; `detail` stays the first `wait for` input.
    Found on the bench: a tell between two boards logged its remote start as
    an input run. test_runs covers web and MQTT starts between two presses.
2026-10-29 firmware: the stack check reads the build PlatformIO wrote
    tools/stack_check.py read its call graphs and frames from .pio/build only,
    so a build under PLATFORMIO_BUILD_DIR failed its post-build stack check
    ("no call graph") unless .pio/build was a link to it. It now reads
    --build-dir, else PLATFORMIO_BUILD_DIR (relative to the project), else
    .pio/build; tools/stack_post.py passes PlatformIO's build root, so the
    ESP32's check finds the Pico W's graph next to its own frames.
2026-10-29 firmware: a script save or a backup restore keeps a sampled run counted
    A script effect's start can be taken on a 1 ms sample; the next 10 ms
    step reports it. scriptWrite (set_script, put_backup) loaded the runner
    with no table before that step, which set its run counts back to 0, so a
    run started on a sample just before the save or the restore was never
    reported or added to runs_since_power_on / runs_lifetime. scriptWrite now
    reports the runs not yet reported first, as scriptReload does.
    test_runs: a_run_started_on_a_sample_just_before_set_script_is_counted and
    a_run_started_on_a_sample_just_before_put_backup_is_counted (both fail
    without the fix: Expected 1 Was 0).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
2026-10-29 firmware: runs counted while the lifetime count is written stay waiting
    The loop writes the lifetime run count with the lock given back, so the
    step keeps running and can count runs meanwhile. RunCounter::saved set the
    waiting count to 0 afterwards, so those runs were taken as written although
    the record held the count from before the write: a power cut lost them,
    and nothing wrote them until the next run.
    runsSaveNow notes how many runs were waiting when it took the record and
    RunCounter::saved takes off only those; any counted during the write keep
    waiting, their period starting at the write, on the usual throttle (no
    extra write).
    test_runs: a_run_counted_while_the_count_is_written_is_w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
2026-10-29 firmware: CI runs the built-image checks, and a missing image fails them there
    The image checks of test_picoboot_map and test_flash_map read fixed .pio/build paths and passed with
    only a message when an image was missing; CI's host job builds no images and the boards job ran no
    tests, so they never ran. The tests now find images by PLATFORMIO_BUILD_DIR, else .pio/build (the
    rule of tools/stack_check.py, in test/image_paths.h), and fail on a missing image when
    PT_REQUIRE_IMAGES is set. The boards job runs them after the first-flash step with it set; a local
    pio test still skips what is not built.
